OmerNazir/Dremel-charger-reverse-engineering/README.md

# Bosch/Dremel Charger Reverse Engineering

This repository contains a reverse-engineered KiCad schematic of a Bosch/Dremel 3 Li-ion battery charger.

## Purpose

To collaboratively analyze and understand the circuit.

## Status

Work in progress.

## Contributions

Contributions are welcome.
