OmerNazir/Dremel-charger-reverse-engineering/Simulations/Simulation.asc

D1: diode; 1N914
D2: diode; 1N914
D3: diode
D4: diode
L1: ind2; 3.06m; Rser=3
L2: ind2; 8.1µ; Rser=0.17
L3: ind2; 12.3µ
L4: ind2; 8.7µ
M1: nmos; STP8NM60
Q1: npn
R1: res; 0.22
R2: res; 0.22
R3: res; 3.3
R4: res; 1k
R5: res; 610k
R6: res; 510k
R7: res; 33
R8: res; 2k
U1: PC817B
V1: voltage; 400
V2: voltage; PULSE()
Named nets: 0, 400v, Vaux
K1 L1 L2 L3 L4 1
.tran 1m
