OmerNazir/Dremel-charger-reverse-engineering/Dremel_Battery_Charger.kicad_sch

## KiCad design Dremel_Battery_Charger.kicad_sch (2026-04-08)

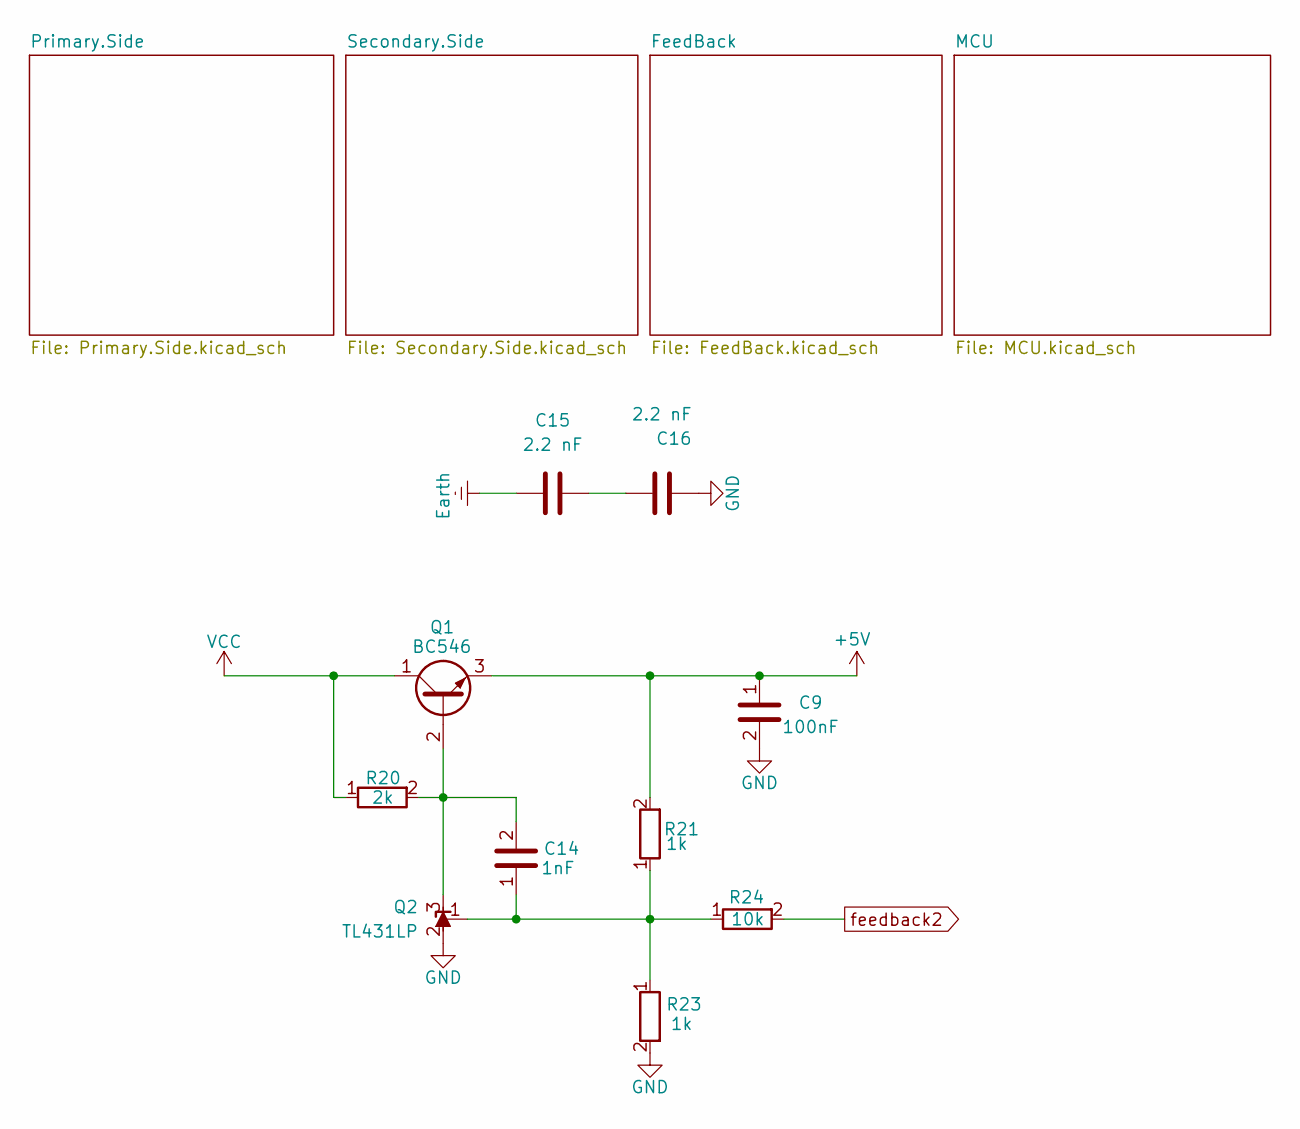
[picture p4: schematic Dremel_Battery_Charger.kicad_sch]

Parts:
C9: 100nF; C_Disc_D5.0mm_W2.5mm_P5.00mm
C14: 1nF; C_Disc_D5.0mm_W2.5mm_P5.00mm
C15, C16: 2.2 nF; C_Disc_D7.5mm_W5.0mm_P10.00mm
Q1: BC546; TO-92L_Wide
Q2: TL431LP; TO-92_Inline
R20: 2k; R_Axial_DIN0207_L6.3mm_D2.5mm_P10.16mm_Horizontal
R21, R23: 1k; R_Axial_DIN0207_L6.3mm_D2.5mm_P10.16mm_Horizontal
R24: 10k; R_Axial_DIN0207_L6.3mm_D2.5mm_P10.16mm_Horizontal

Connections:
+5V: C9.1, Q1.3 (E), R21.2
Earth: C15.1
GND: C9.2, C16.2, Q2.2 (A), R23.2
unnamed: C14.1, Q2.1 (REF), R21.1, R23.1, R24.1
unnamed: C14.2, Q1.2 (B), Q2.3 (K), R20.2
unnamed: C15.2, C16.1
VCC: Q1.1 (C), R20.1
feedback2: R24.2
