OmerNazir/Dremel-charger-reverse-engineering/FeedBack.kicad_sch

## KiCad design FeedBack.kicad_sch (2026-04-08)

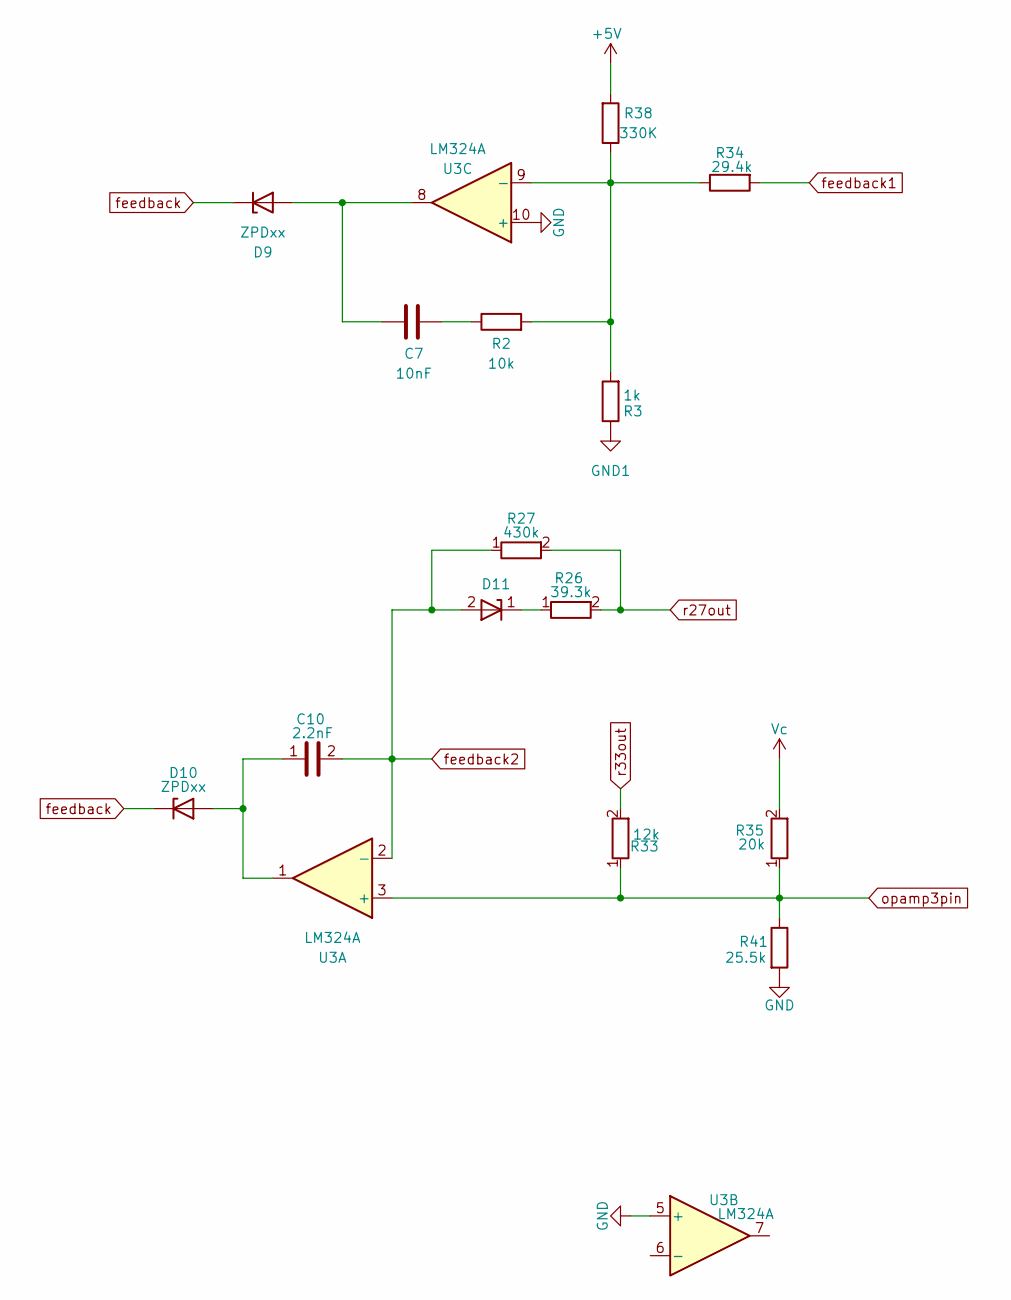
[picture p5: schematic FeedBack.kicad_sch]

Parts:
C7: 10nF; C_Disc_D5.0mm_W2.5mm_P5.00mm
C10: 2.2nF; C_Disc_D5.0mm_W2.5mm_P5.00mm
D9, D10, D11: ZPDxx; D_DO-35_SOD27_P10.16mm_Horizontal
R2: 10k; R_Axial_DIN0207_L6.3mm_D2.5mm_P10.16mm_Horizontal
R3: 1k; R_Axial_DIN0207_L6.3mm_D2.5mm_P10.16mm_Horizontal
R26: 39.3k; R_Axial_DIN0207_L6.3mm_D2.5mm_P10.16mm_Horizontal
R27: 430k; R_Axial_DIN0207_L6.3mm_D2.5mm_P10.16mm_Horizontal
R33: 12k; R_Axial_DIN0207_L6.3mm_D2.5mm_P10.16mm_Horizontal
R34: 29.4k; R_Axial_DIN0207_L6.3mm_D2.5mm_P10.16mm_Horizontal
R35: 20k; R_Axial_DIN0207_L6.3mm_D2.5mm_P10.16mm_Horizontal
R38: 330K; R_Axial_DIN0207_L6.3mm_D2.5mm_P10.16mm_Horizontal
R41: 25.5k; R_Axial_DIN0207_L6.3mm_D2.5mm_P10.16mm_Horizontal
U3: LM324A; DIP-14_W7.62mm

Connections:
+5V: R38.2
GND: R41.2, U3.5 (+), U3.10 (+)
GND1: R3.1
unnamed: C7.1, D9.2 (A), U3.8
unnamed: C7.2, R2.1
unnamed: C10.1, D10.2 (A), U3.1
unnamed: D11.1 (K), R26.1
unnamed: R2.2, R3.2, R34.1, R38.1, U3.9 (-)
Vc: R35.2
feedback: D9.1 (K), D10.1 (K)
feedback1: R34.2
feedback2: C10.2, D11.2 (A), R27.1, U3.2 (-)
opamp3pin: R33.1, R35.1, R41.1, U3.3 (+)
r27out: R26.2, R27.2
r33out: R33.2
