OmerNazir/Dremel-charger-reverse-engineering/MCU.kicad_sch

## KiCad design MCU.kicad_sch (2026-04-08)

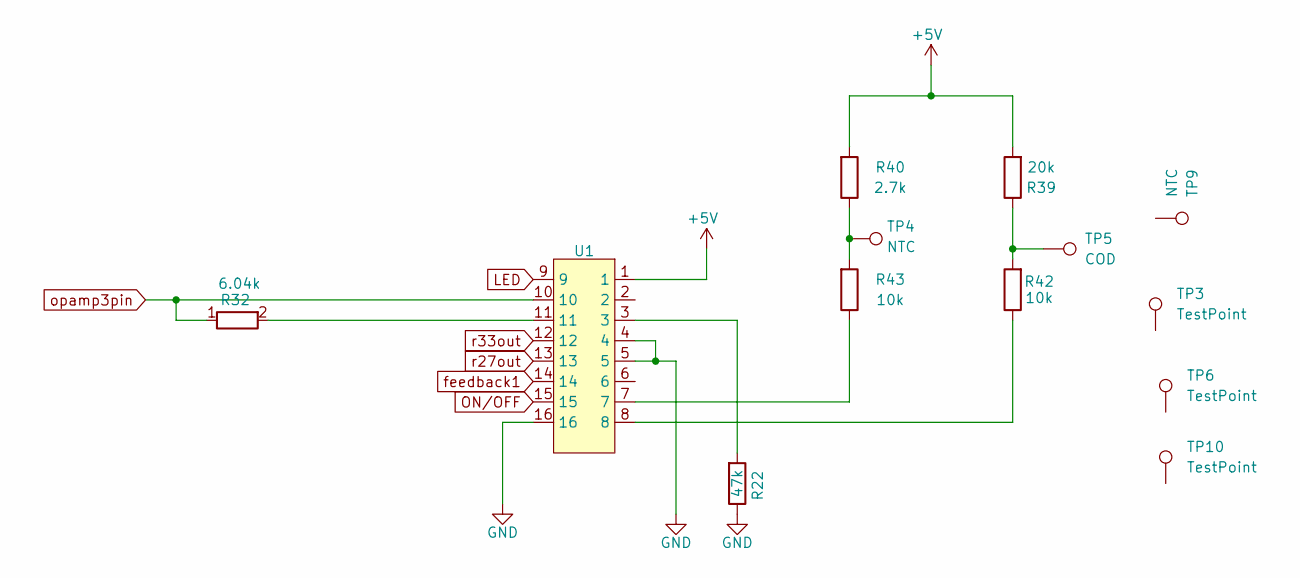
[picture p6: schematic MCU.kicad_sch]

Parts:
R22: 47k; R_Axial_DIN0207_L6.3mm_D2.5mm_P10.16mm_Horizontal
R32: 6.04k; R_Axial_DIN0207_L6.3mm_D2.5mm_P10.16mm_Horizontal
R39: 20k; R_Axial_DIN0207_L6.3mm_D2.5mm_P10.16mm_Horizontal
R40: 2.7k; R_Axial_DIN0207_L6.3mm_D2.5mm_P10.16mm_Horizontal
R42, R43: 10k; R_Axial_DIN0207_L6.3mm_D2.5mm_P10.16mm_Horizontal
TP3, TP6, TP10: TestPoint; TestPoint_Keystone_5010-5014_Multipurpose
TP4, TP9: NTC; TestPoint_Keystone_5010-5014_Multipurpose
TP5: COD; TestPoint_Keystone_5010-5014_Multipurpose
U1: DIP-14_W7.62mm

Connections:
+5V: R39.2, R40.2, U1.1
GND: R22.1, U1.4, U1.5, U1.16
LED: U1.9
unnamed: R22.2, U1.3
unnamed: R32.2, U1.11
unnamed: R39.1, R42.2, TP5.1
unnamed: R40.1, R43.2, TP4.1
unnamed: R42.1, U1.8
unnamed: R43.1, U1.7
ON/OFF: U1.15
feedback1: U1.14
opamp3pin: R32.1, U1.10
r27out: U1.13
r33out: U1.12
