OmerNazir/Dremel-charger-reverse-engineering/Primary.Side.kicad_sch

## KiCad design Primary.Side.kicad_sch (2026-04-08)

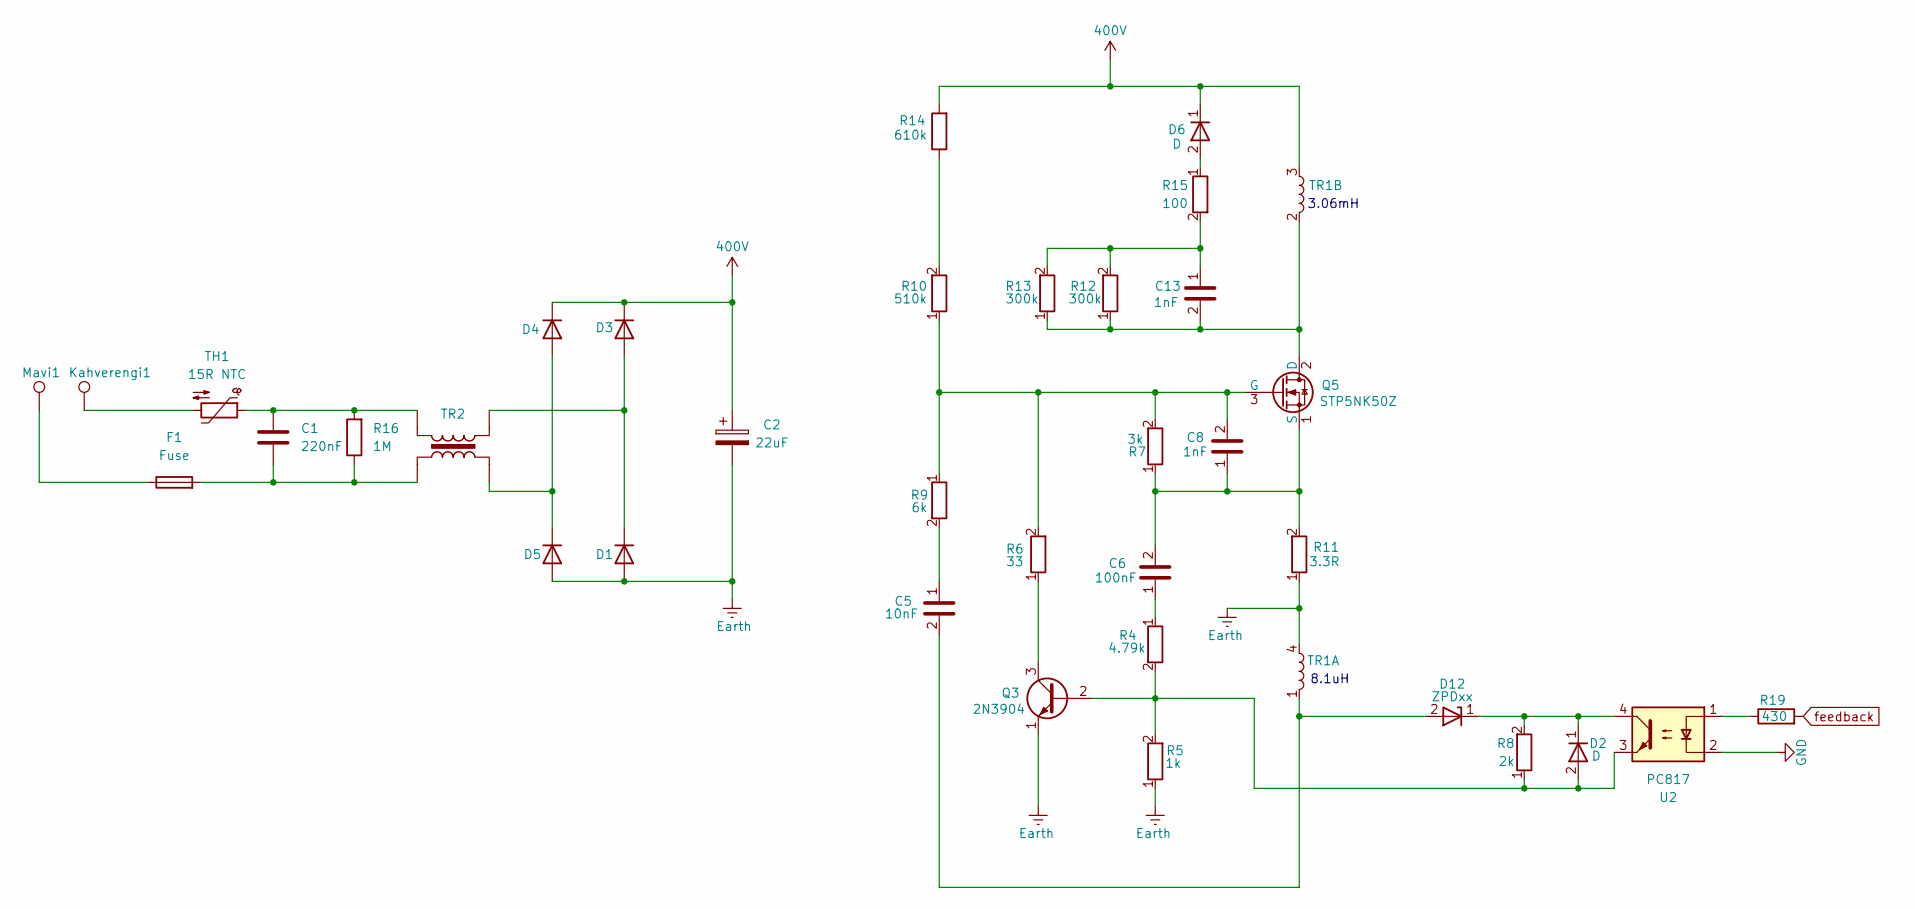
[picture p7: schematic Primary.Side.kicad_sch]

Parts:
C1: 220nF; C_Rect_L19.0mm_W7.0mm_P15.00mm_MKS4
C2: 22uF; CP_Radial_Tantal_D9.0mm_P5.00mm
C5: 10nF; C_Disc_D5.0mm_W2.5mm_P5.00mm
C6: 100nF; C_Disc_D5.0mm_W2.5mm_P5.00mm
C8, C13: 1nF; C_Disc_D5.0mm_W2.5mm_P5.00mm
D1, D2, D3, D4, D5, D6: D; D_DO-34_SOD68_P10.16mm_Horizontal
D12: ZPDxx; D_DO-35_SOD27_P10.16mm_Horizontal
F1: Fuse; Fuseholder_Littelfuse_445_030_series_5x30mm
Kahverengi1: TestPoint; PinHeader_1x01_P1.27mm_Vertical
Mavi1: TestPoint; PinHeader_1x01_P1.27mm_Vertical
Q3: 2N3904; TO-92L
Q5: STP5NK50Z; TO-92L_Wide
R4: 4.79k; R_Axial_DIN0207_L6.3mm_D2.5mm_P10.16mm_Horizontal
R5: 1k; R_Axial_DIN0207_L6.3mm_D2.5mm_P10.16mm_Horizontal
R6: 33; R_Axial_DIN0207_L6.3mm_D2.5mm_P10.16mm_Horizontal
R7: 3k; R_Axial_DIN0207_L6.3mm_D2.5mm_P10.16mm_Horizontal
R8: 2k; R_Axial_DIN0207_L6.3mm_D2.5mm_P10.16mm_Horizontal
R9: 6k; R_Axial_DIN0207_L6.3mm_D2.5mm_P10.16mm_Horizontal
R10: 510k; R_Axial_DIN0207_L6.3mm_D2.5mm_P10.16mm_Horizontal
R11: 3.3R; R_Axial_DIN0207_L6.3mm_D2.5mm_P10.16mm_Horizontal
R12, R13: 300k; R_Axial_DIN0207_L6.3mm_D2.5mm_P10.16mm_Horizontal
R14: 610k; R_Axial_DIN0207_L6.3mm_D2.5mm_P10.16mm_Horizontal
R15: 100; R_Axial_DIN0207_L6.3mm_D2.5mm_P10.16mm_Horizontal
R16: 1M; R_Axial_DIN0207_L6.3mm_D2.5mm_P10.16mm_Horizontal
R19: 430; R_Axial_DIN0207_L6.3mm_D2.5mm_P10.16mm_Horizontal
TH1: 15R NTC; R_Axial_DIN0204_L3.6mm_D1.6mm_P5.08mm_Vertical
TR1: charger_trafo
TR2: common Mode choke; SW_Push_2P1T_Toggle_CK_PVA1xxH1xxxxxxV2
U2: PC817; DIP-4_W7.62mm_Socket

Connections:
400V: C2.1, D3.1 (K), D4.1 (K), D6.1 (K), R14.2, TR1.3
Earth: C2.2, D1.2 (A), D5.2 (A), Q3.1 (E), R5.1, R11.1, TR1.4
GND: U2.2
unnamed: C1.1, R16.2, TH1.1, TR2.1
unnamed: C1.2, F1.2, R16.1, TR2.4
unnamed: C5.1, R9.2
unnamed: C5.2, D12.2 (A), TR1.1
unnamed: C6.1, R4.1
unnamed: C6.2, C8.1, Q5.1 (S), R7.1, R11.2
unnamed: C8.2, Q5.3 (G), R6.2, R7.2, R9.1, R10.1
unnamed: C13.1, R12.2, R13.2, R15.2
unnamed: C13.2, Q5.2 (D), R12.1, R13.1, TR1.2
unnamed: D1.1 (K), D3.2 (A), TR2.2
unnamed: D2.2 (A), Q3.2 (B), R4.2, R5.2, R8.1, U2.3
unnamed: D4.2 (A), D5.1 (K), TR2.3
unnamed: D6.2 (A), R15.1
unnamed: D2.1 (K), D12.1 (K), R8.2, U2.4
unnamed: F1.1, Mavi1.1
unnamed: Kahverengi1.1, TH1.2
unnamed: Q3.3 (C), R6.1
unnamed: R10.2, R14.1
unnamed: R19.1, U2.1
feedback: R19.2

Notes on the sheet:
8.1uH
3.06mH
