OmerNazir/Dremel-charger-reverse-engineering/Secondary.Side.kicad_sch

## KiCad design Secondary.Side.kicad_sch (2026-04-08)

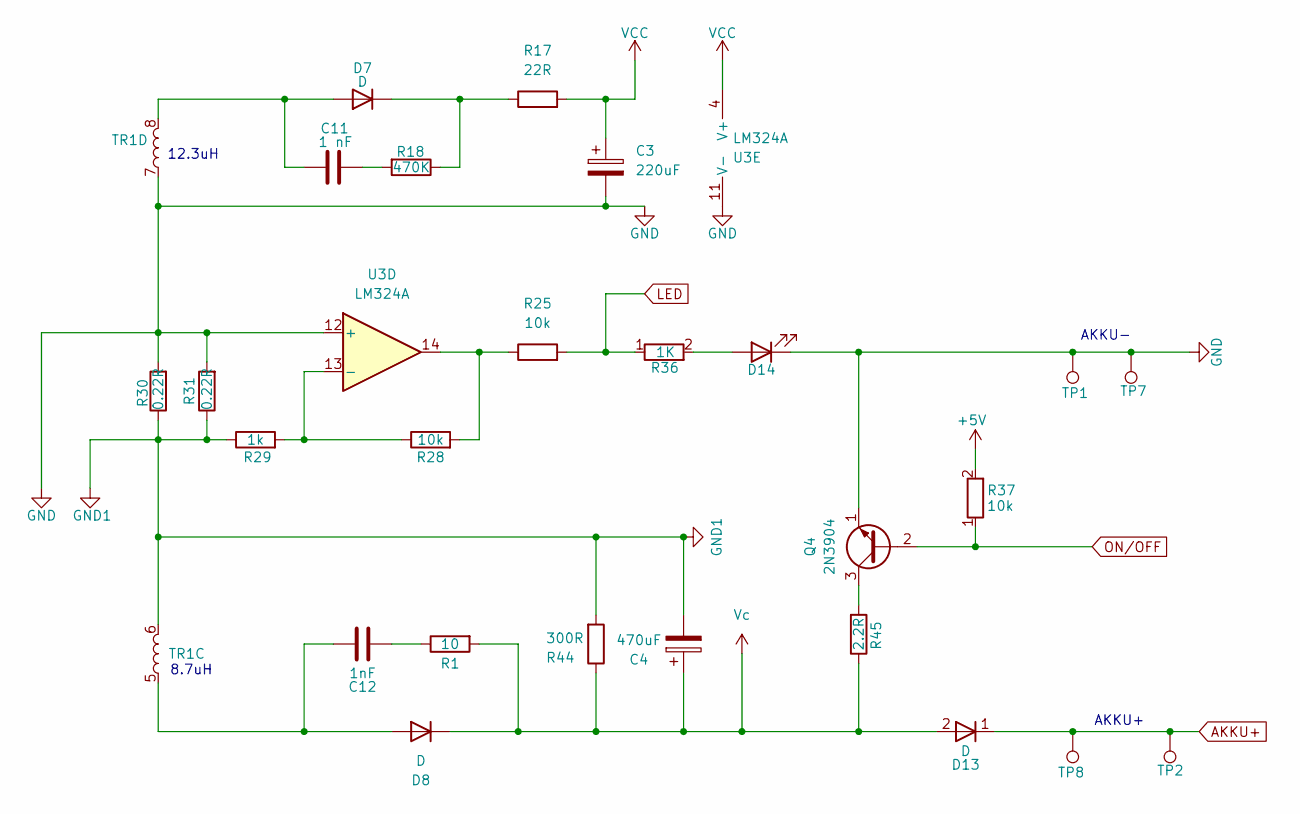
[picture p8: schematic Secondary.Side.kicad_sch]

Parts:
C3: 220uF; CP_Radial_D8.0mm_P3.50mm
C4: 470uF; CP_Radial_Tantal_D9.0mm_P5.00mm
C11: 1 nF; C_Disc_D5.0mm_W2.5mm_P5.00mm
C12: 1nF; C_Disc_D5.0mm_W2.5mm_P5.00mm
D7: D; D_DO-34_SOD68_P10.16mm_Horizontal
D8, D13: D; D_DO-201AE_P15.24mm_Horizontal
D14: LED; LED_D1.8mm_W1.8mm_H2.4mm_Horizontal_O1.27mm_Z1.6mm
Q4: 2N3904; TO-92L_Wide
R1: 10; R_Axial_DIN0207_L6.3mm_D2.5mm_P10.16mm_Horizontal
R17: 22R; R_Axial_DIN0207_L6.3mm_D2.5mm_P10.16mm_Horizontal
R18: 470K; R_Axial_DIN0207_L6.3mm_D2.5mm_P10.16mm_Horizontal
R25, R28, R37: 10k; R_Axial_DIN0207_L6.3mm_D2.5mm_P10.16mm_Horizontal
R29: 1k; R_Axial_DIN0207_L6.3mm_D2.5mm_P10.16mm_Horizontal
R30, R31: 0.22R; R_Axial_DIN0207_L6.3mm_D2.5mm_P10.16mm_Horizontal
R36: 1K; R_Axial_DIN0207_L6.3mm_D2.5mm_P10.16mm_Horizontal
R44: 300R; R_Axial_DIN0411_L9.9mm_D3.6mm_P15.24mm_Horizontal
R45: 2.2R; R_Axial_DIN0411_L9.9mm_D3.6mm_P15.24mm_Horizontal
TP1, TP2, TP7, TP8: TestPoint; TestPoint_Keystone_5010-5014_Multipurpose
TR1: charger_trafo
U3: LM324A; DIP-14_W7.62mm

Connections:
+5V: R37.2
AKKU+: D13.1 (K), TP2.1, TP8.1
GND: C3.2, D14.1 (K), Q4.1 (E), R30.2, R31.2, TP1.1, TP7.1, TR1.7, U3.11 (V-), U3.12 (+)
GND1: C4.2, R29.1, R30.1, R31.1, R44.2, TR1.6
LED: R25.2, R36.1
unnamed: C11.1, D7.2 (A), TR1.8
unnamed: C11.2, R18.2
unnamed: C12.1, R1.1
unnamed: C12.2, D8.2 (A), TR1.5
unnamed: D7.1 (K), R17.1, R18.1
unnamed: D14.2 (A), R36.2
unnamed: Q4.3 (C), R45.2
unnamed: R25.1, R28.2, U3.14
unnamed: R28.1, R29.2, U3.13 (-)
ON/OFF: Q4.2 (B), R37.1
VCC: C3.1, R17.2, U3.4 (V+)
Vc: C4.1, D8.1 (K), D13.2 (A), R1.2, R44.1, R45.1

Notes on the sheet:
8.7uH
AKKU-
AKKU+
12.3uH
